Harrishayy/SysEng/SystemsEngineering_Team05_Presentation.pdf

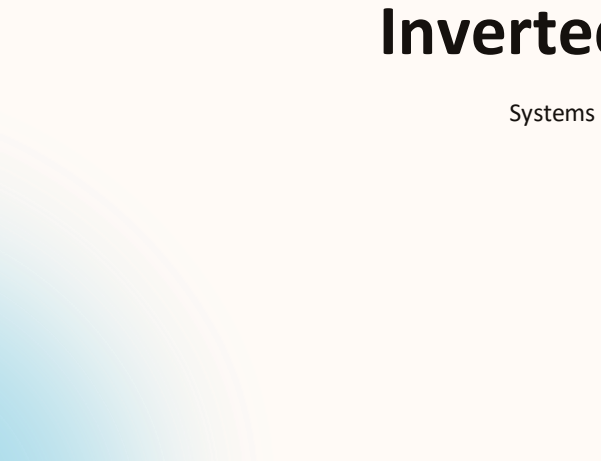
[picture p40: figure]

# Inverted Pendulum

### Systems Engineering – Team 05

# Equations of Motion

Non-linear Dynamics (Lagrangian Approach):

We derived the system's "True Physics" using the Euler-Lagrange method to capture real-world non-linearities like centripetal forces

Translation:

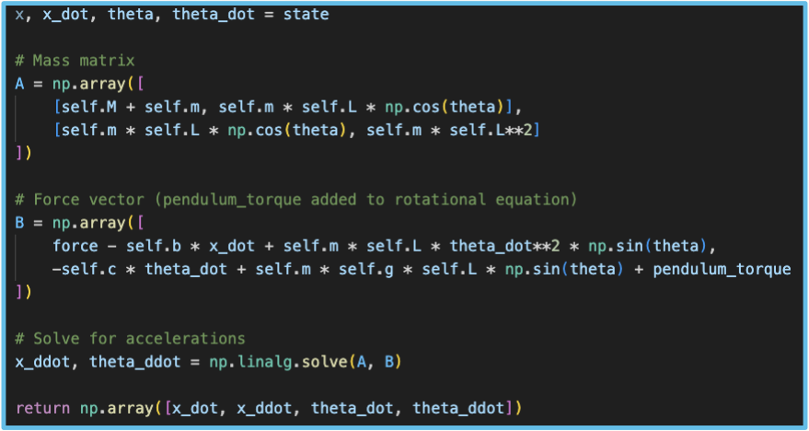
[picture p41: figure]

Rotation:

Code Implementation:

In our Python implementation, we utilize a Mass Matrix (A) and a Force Vector (B̈) to solve for accelerations (ẍ, θ̈) at every time step.

State Representation: The system state is tracked as a 4D vector:

# Controller Design - PID

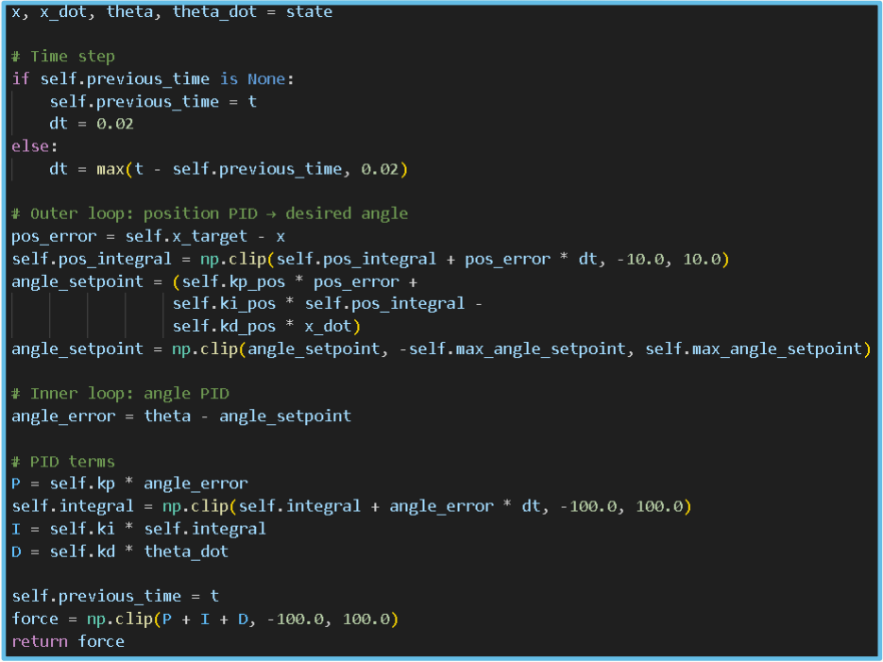
[picture p42: figure]
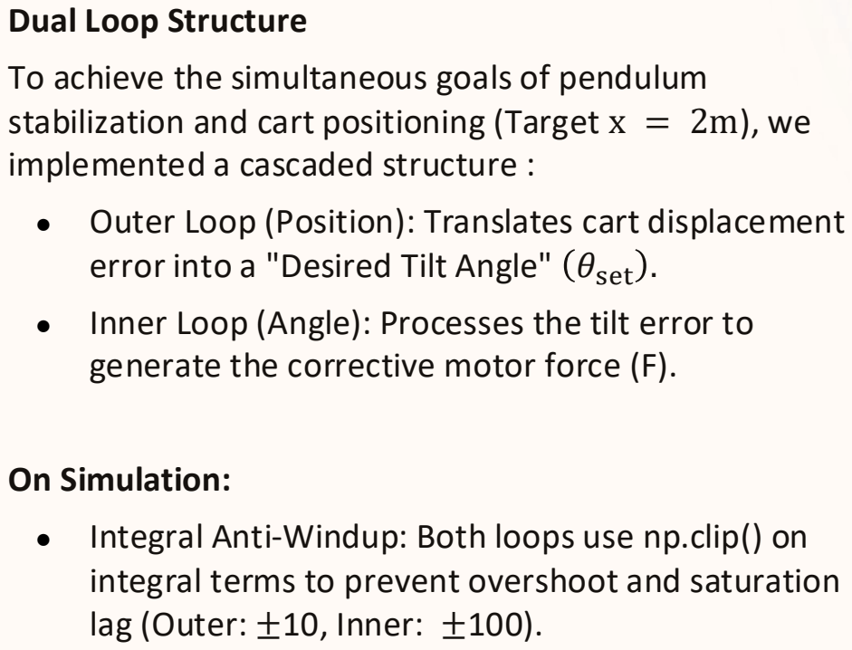
[picture p43: figure]
Dual Loop Structure; implemented a cascaded structure :; On Simulation:; lag (Outer: ±10, Inner: ±100).

To achieve the simultaneous goals of pendulum stabilization and cart positioning (Target x = 2m), we

- Outer Loop (Position): Translates cart displacement error into a "Desired Tilt Angle" θset .
- Inner Loop (Angle): Processes the tilt error to generate the corrective motor force (F).
- Integral Anti-Windup: Both loops use np.clip() on integral terms to prevent overshoot and saturation

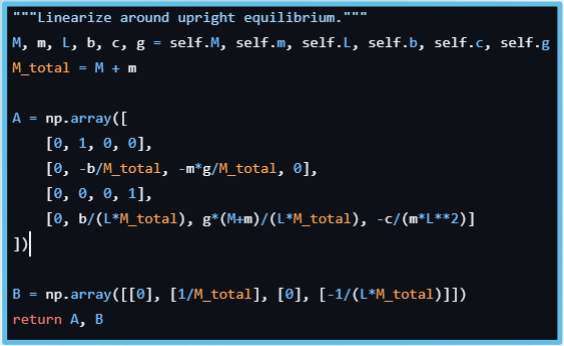
[picture p44: figure]

# Controller Design - LQR

Optimal State-Feedback Control Strategy

Unlike our PID controller, which uses a dual loop structure, the LQR uses a single unified controller.

Target state: x = [2 0 0 0]T
First the dynamics are linearised (state x = [x ẋ θ θ])
into the form ẋ = A x + B u.

Then, the quadratic cost function is minimised.

Control Law

The optimal feedback gain K is then computed by solving the CARE equation. The control force is then calculated as:

u=−K(x−xsetpoint )

where K = [kx

, kẋ

, kθ

, kθ

]

Therefore, all 4 states (position, velocity, angle, angular velocity) contribute to the control force simultaneously.

# Controller Design – Pole Placement

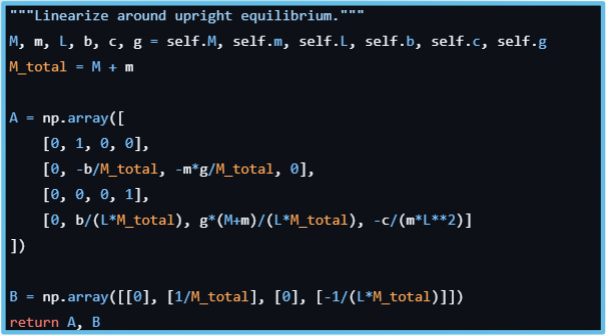
[picture p45: figure]

### Optimised State-Feedback Control Strategy

Rather than optimising a cost function like LQR, pole placement directly assigns the closed loop dynamics of the system. The rest of the initial setup for this design is the same as LQR: same target x and linearising the state.

### Control Law

Rather than solving the CARE equation, the gain matrix K is calculated such that eig(A-BK) = desired poles

It then uses the same logic as LQR to compute the control force, therefore all states contribute to the force simultaneously.

# Sensor Noise and Hardware Realism

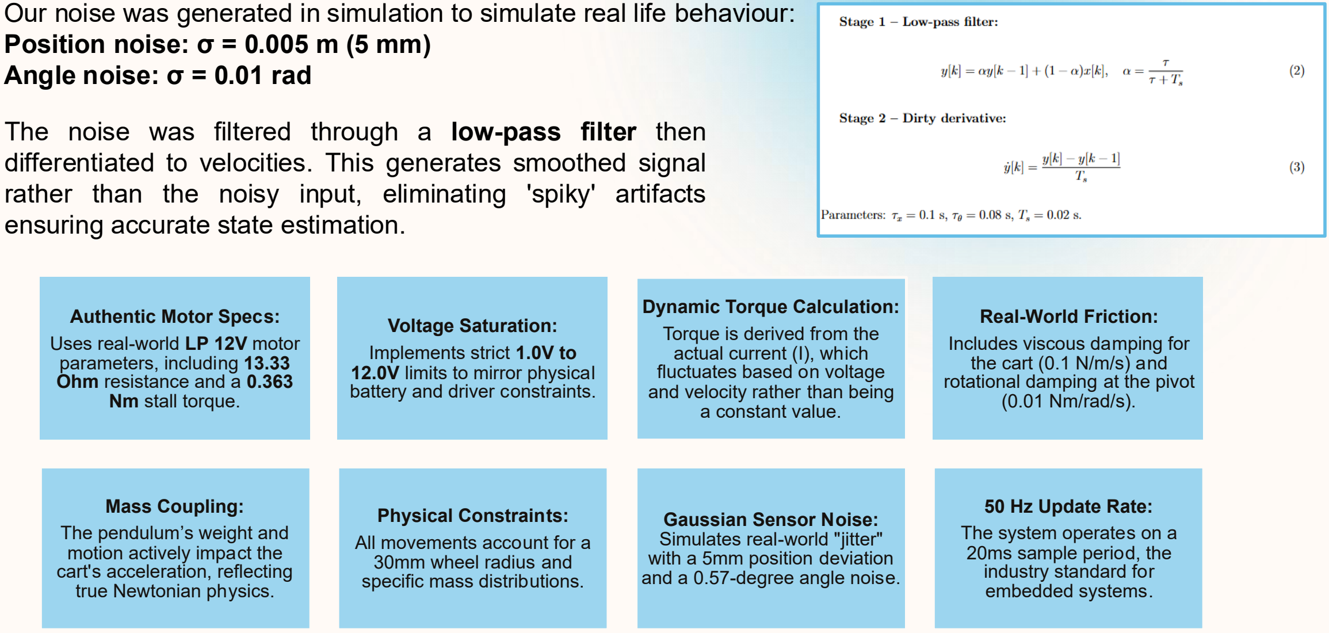
[picture p46: figure]
Position noise: σ = 0.005 m (5 mm) Angle noise: σ = 0.01 rad; ensuring accurate state estimation.; Authentic Motor Specs:; Uses real-world LP 12V motor parameters, including 13.33 Ohm resistance and a 0.363 Nm stall torque.; Voltage Saturation:; Implements strict 1.0V to 12.0V limits to mirror physical battery and driver constraints.; Dynamic Torque Calculation:; Torque is derived from the actual current (I), which fluctuates based on voltage and velocity rather than being a constant value.; Real-World Friction:; Includes viscous damping for the cart (0.1 N/m/s) and rotational damping at the pivot (0.01 Nm/rad/s).; Mass Coupling:; The pendulum’s weight and motion actively impact the cart's acceleration, reflecting true Newtonian physics.; Physical Constraints:; All movements account for a 30mm wheel radius and specific mass distributions.; Gaussian Sensor Noise: Simulates real-world "jitter" with a 5mm position deviation and a 0.57-degree angle noise.; 50 Hz Update Rate:; The system operates on a 20ms sample period, the industry standard for embedded systems.

Our noise was generated in simulation to simulate real life behaviour:

The noise was filtered through a low-pass filter then differentiated to velocities. This generates smoothed signal rather than the noisy input, eliminating 'spiky' artifacts

# Batch Comparison

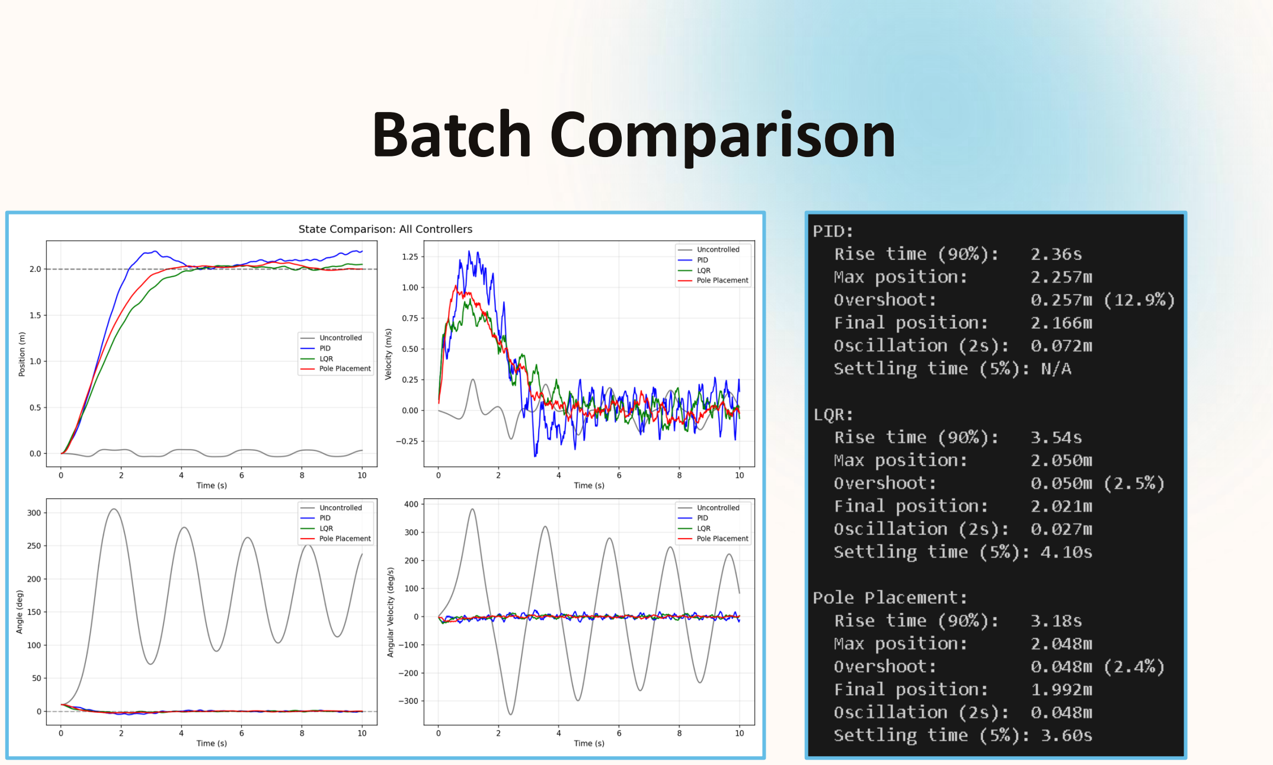
[picture p47: page 7]

# Performance Testing

Max Initial Angle Test
- Uses binary search between 5° and 60° to find the largest starting tilt the controller can recover from
- Runs 10-second simulation with noise and motor constraints
- Pass criteria: Pendulum stays within ±90° throughout AND ends within ±30°

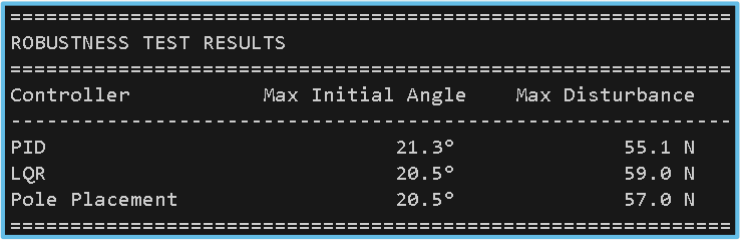
[picture p48: figure]

Max Disturbance Test
- Starts with small 5° tilt, applies an impulse force at t=2s
- Binary searches between 0-100N to find maximum survivable push
- Simulates real-world bumps/collisions the system might experience
