Harrishayy/SysEng/hardware_plots/fig_dist_pos.png

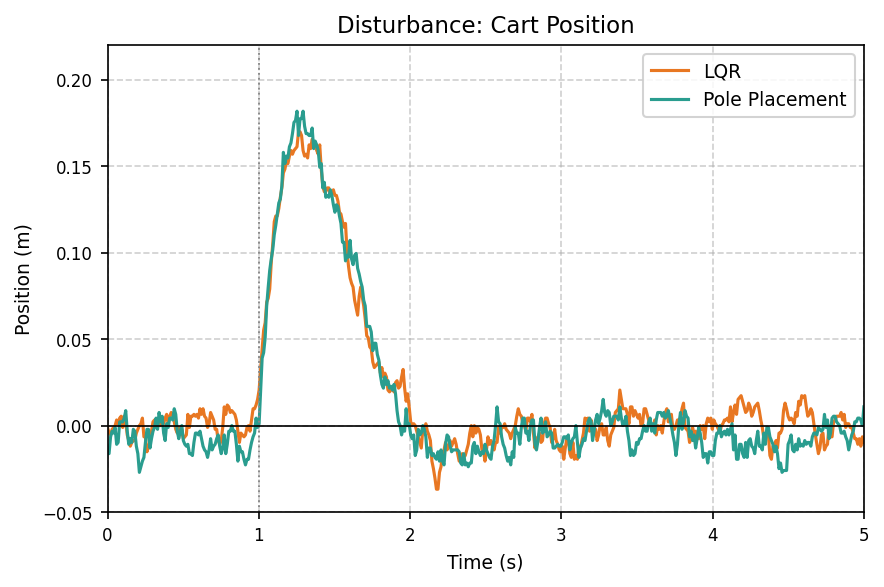
hardware_plots/fig_dist_pos.png
