Harrishayy/SysEng/hardware_plots/fig_sprint_pos.png

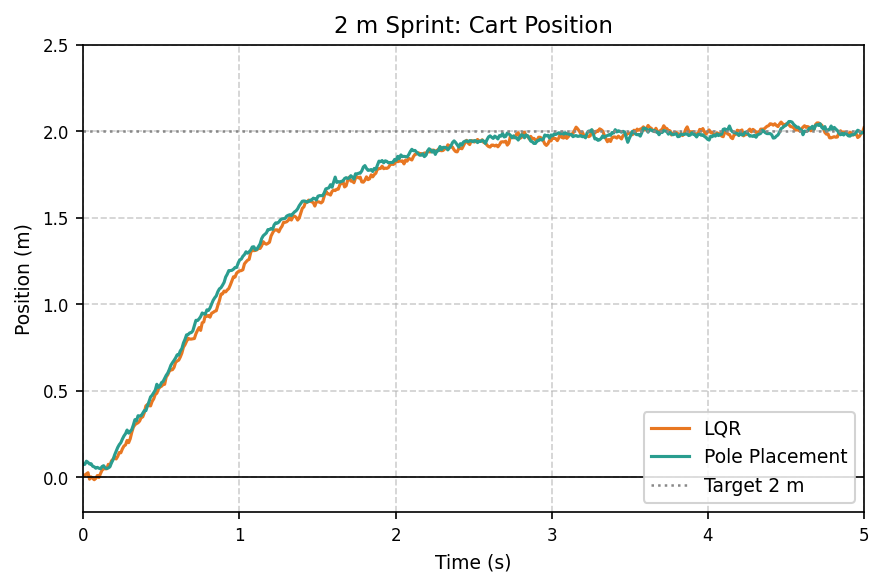
hardware_plots/fig_sprint_pos.png
