Harrishayy/SysEng/plots/comparison_angle.png

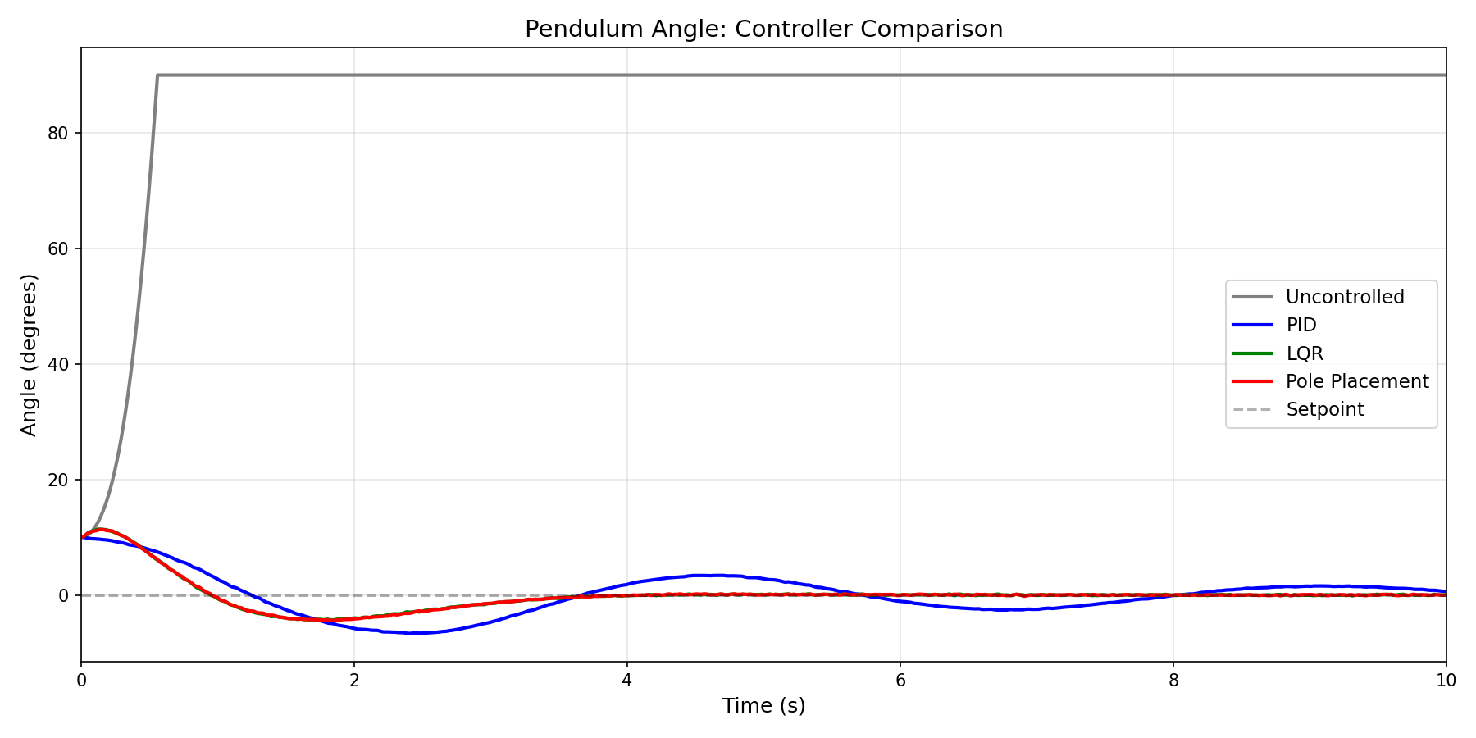
plots/comparison_angle.png
