Harrishayy/SysEng/plots/comparison_control.png

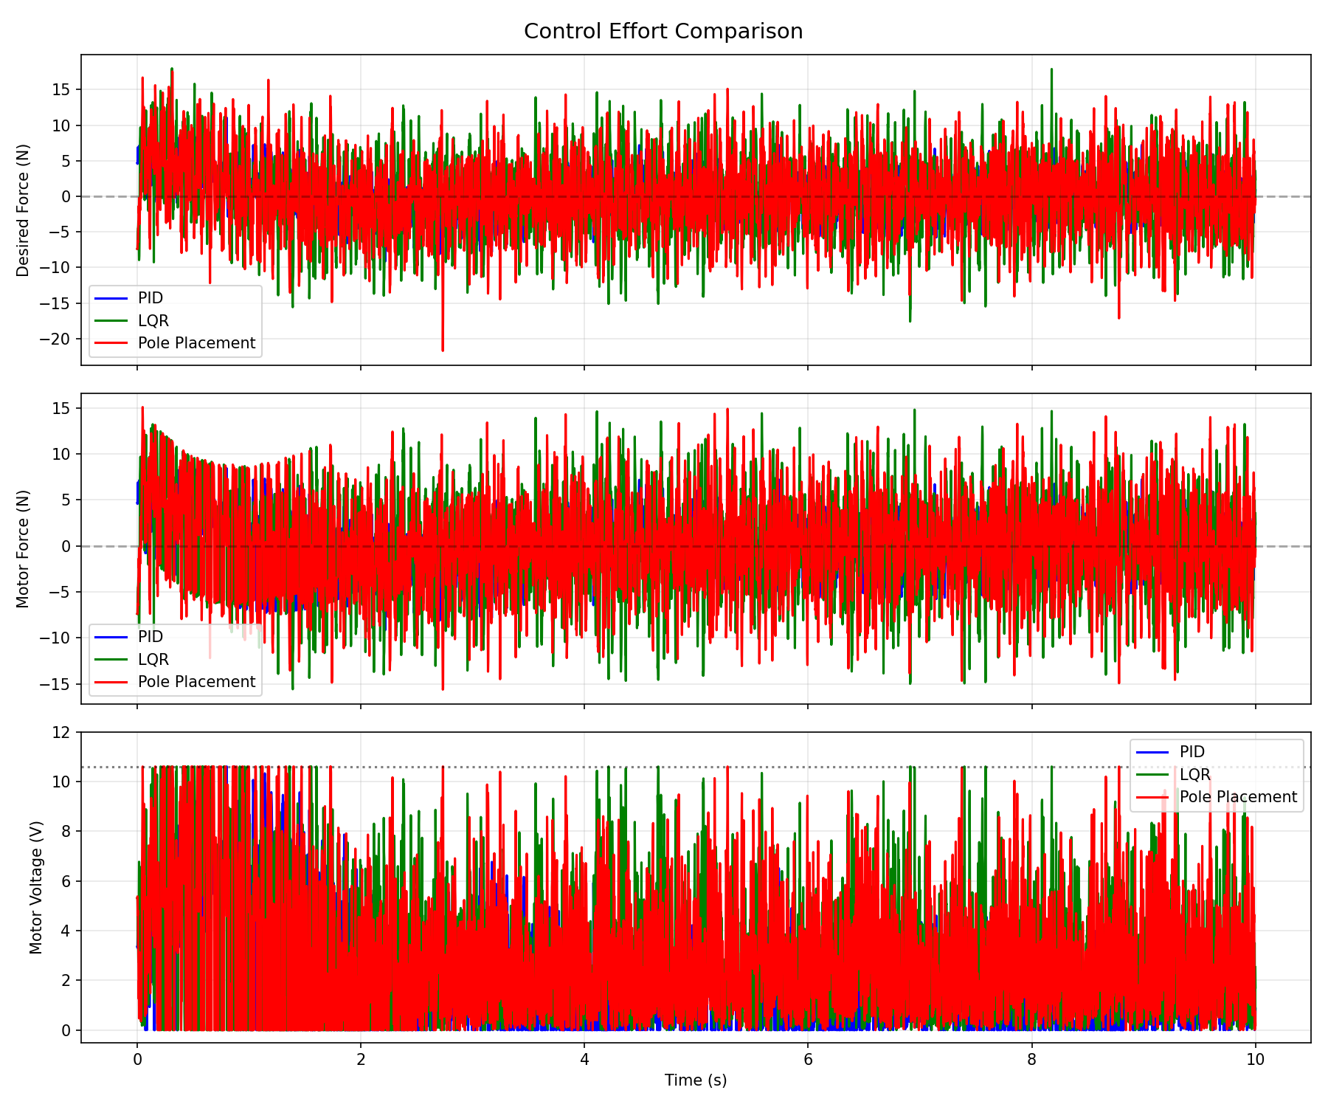
plots/comparison_control.png
