Harrishayy/SysEng/plots/comparison_metrics.png

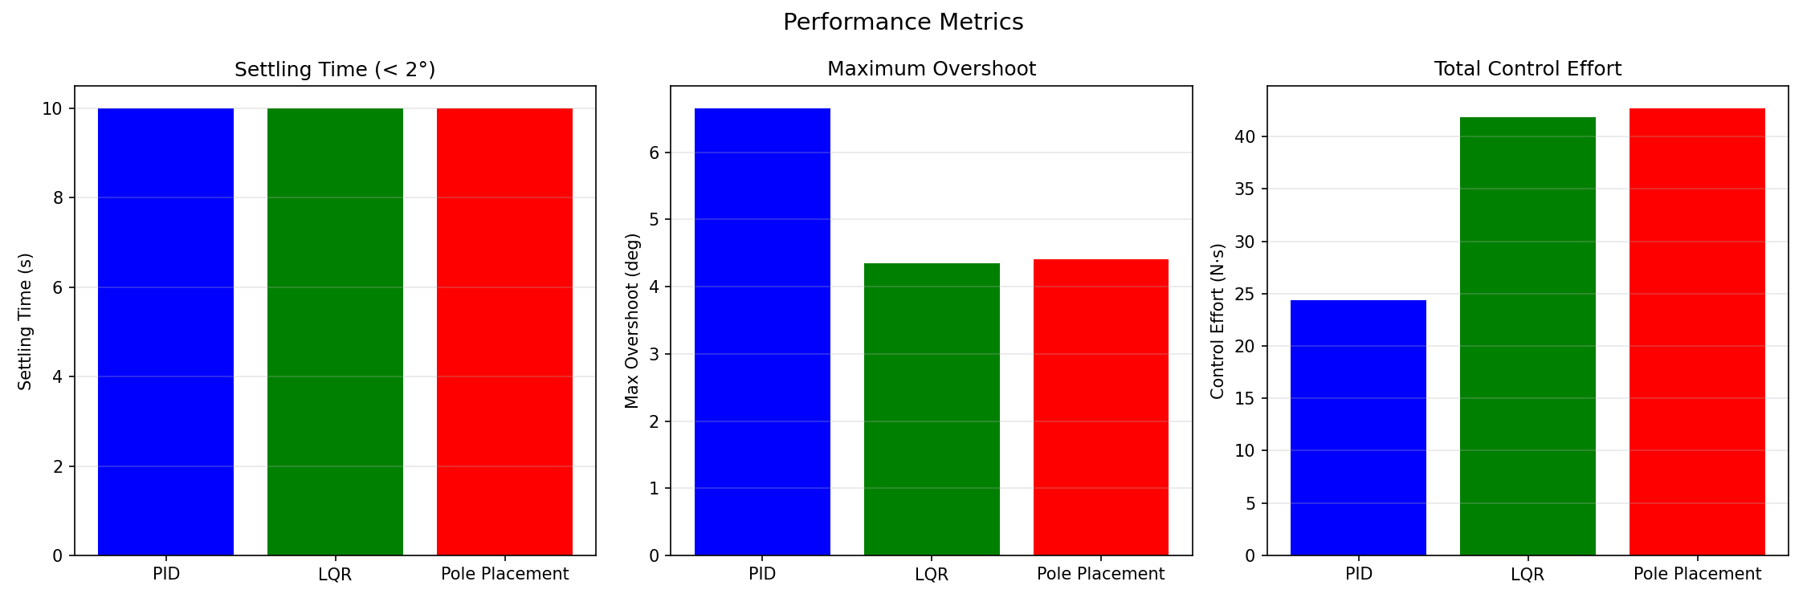
plots/comparison_metrics.png
