Harrishayy/SysEng/plots/comparison_phase.png

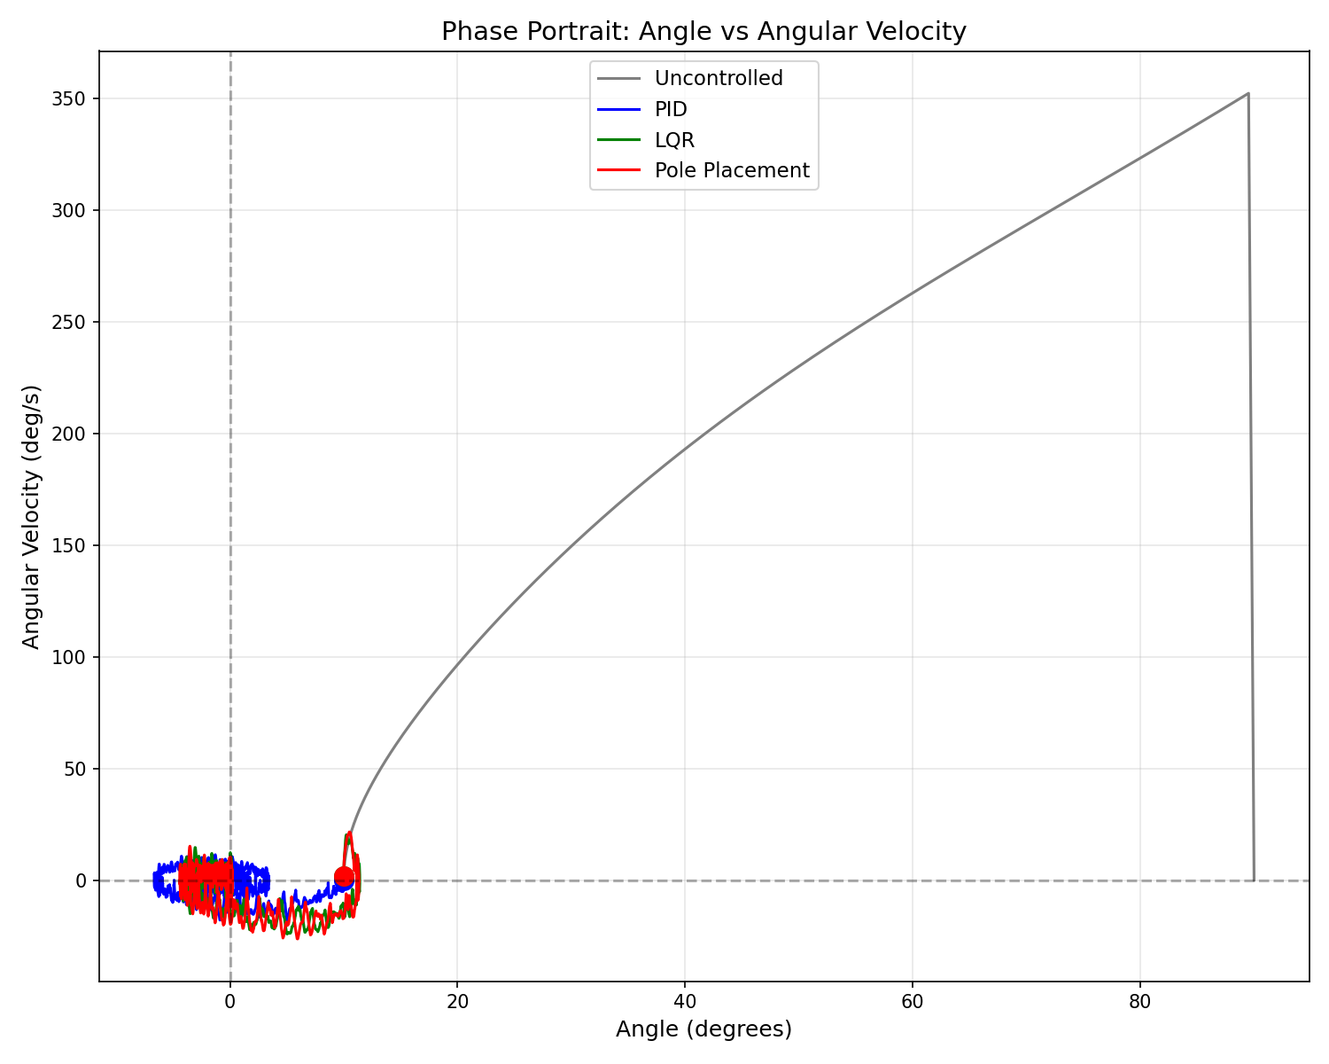
plots/comparison_phase.png
