Harrishayy/SysEng/plots/comparison_position.png

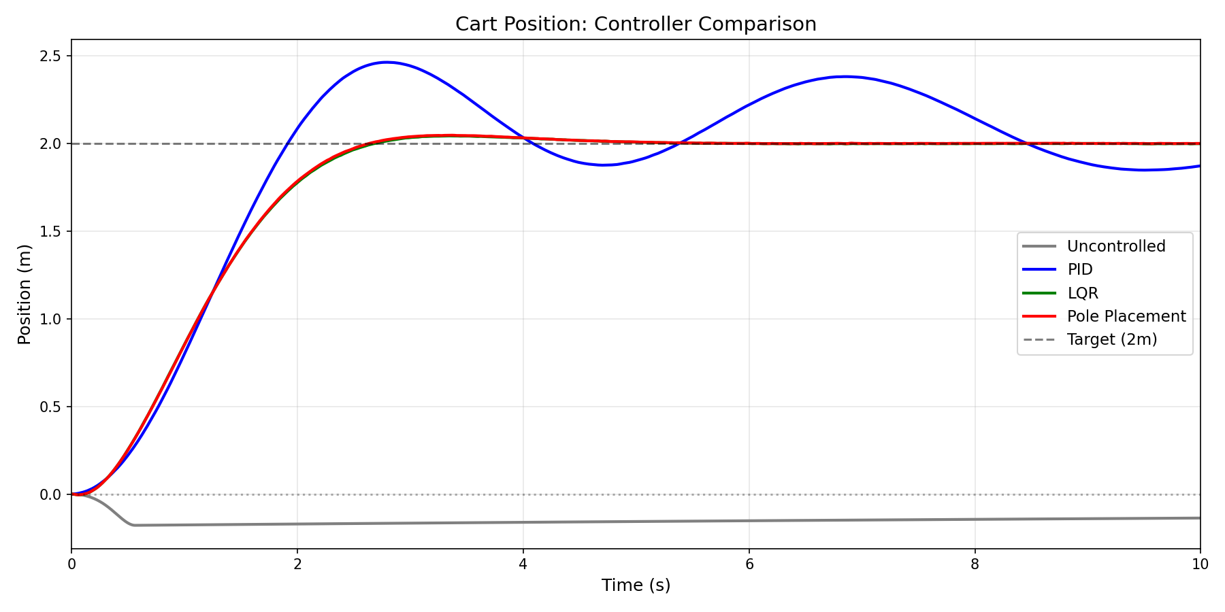
plots/comparison_position.png
