Harrishayy/SysEng/Sensors/Tests/SwingTestResult.txt

AS22 Encoder Test Initialized
Assumed CPR: 1000.00
Count: 39	 Angle: 14.04 deg
Count: 39	 Angle: 14.04 deg
Count: 40	 Angle: 14.40 deg
Count: 40	 Angle: 14.40 deg
Count: 40	 Angle: 14.40 deg
Count: 40	 Angle: 14.40 deg
Count: 40	 Angle: 14.40 deg
Count: 40	 Angle: 14.40 deg
Count: 40	 Angle: 14.40 deg
Count: 39	 Angle: 14.04 deg
Count: 39	 Angle: 14.04 deg
Count: 39	 Angle: 14.04 deg
Count: 39	 Angle: 14.04 deg
Count: 38	 Angle: 13.68 deg
Count: 38	 Angle: 13.68 deg
Count: 37	 Angle: 13.32 deg
Count: 37	 Angle: 13.32 deg
Count: 36	 Angle: 12.96 deg
Count: 35	 Angle: 12.60 deg
Count: 34	 Angle: 12.24 deg
Count: 34	 Angle: 12.24 deg
Count: 33	 Angle: 11.88 deg
Count: 32	 Angle: 11.52 deg
Count: 31	 Angle: 11.16 deg
Count: 30	 Angle: 10.80 deg
Count: 28	 Angle: 10.08 deg
Count: 27	 Angle: 9.72 deg
Count: 26	 Angle: 9.36 deg
Count: 24	 Angle: 8.64 deg
Count: 23	 Angle: 8.28 deg
Count: 22	 Angle: 7.92 deg
Count: 20	 Angle: 7.20 deg
Count: 19	 Angle: 6.84 deg
Count: 17	 Angle: 6.12 deg
Count: 15	 Angle: 5.40 deg
Count: 14	 Angle: 5.04 deg
Count: 12	 Angle: 4.32 deg
Count: 10	 Angle: 3.60 deg
Count: 9	 Angle: 3.24 deg
Count: 7	 Angle: 2.52 deg
Count: 6	 Angle: 2.16 deg
Count: 4	 Angle: 1.44 deg
Count: 2	 Angle: 0.72 deg
Count: 1	 Angle: 0.36 deg
Count: -1	 Angle: 359.64 deg
Count: -3	 Angle: 358.92 deg
Count: -4	 Angle: 358.56 deg
Count: -6	 Angle: 357.84 deg
Count: -8	 Angle: 357.12 deg
Count: -10	 Angle: 356.40 deg
Count: -11	 Angle: 356.04 deg
Count: -13	 Angle: 355.32 deg
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
Count: 16	 Angle: 5.76 deg
Count: 17	 Angle: 6.12 deg
Count: 19	 Angle: 6.84 deg
Count: 20	 Angle: 7.20 deg
Count: 21	 Angle: 7.56 deg
Count: 21	 Angle: 7.56 deg
Count: 22	 Angle: 7.92 deg
Count: 23	 Angle: 8.28 deg
Count: 24	 Angle: 8.64 deg
Count: 24	 Angle: 8.64 deg
Count: 25	 Angle: 9.00 deg
