Harrishayy/SysEng/hardware_plots/realistic_performance.png

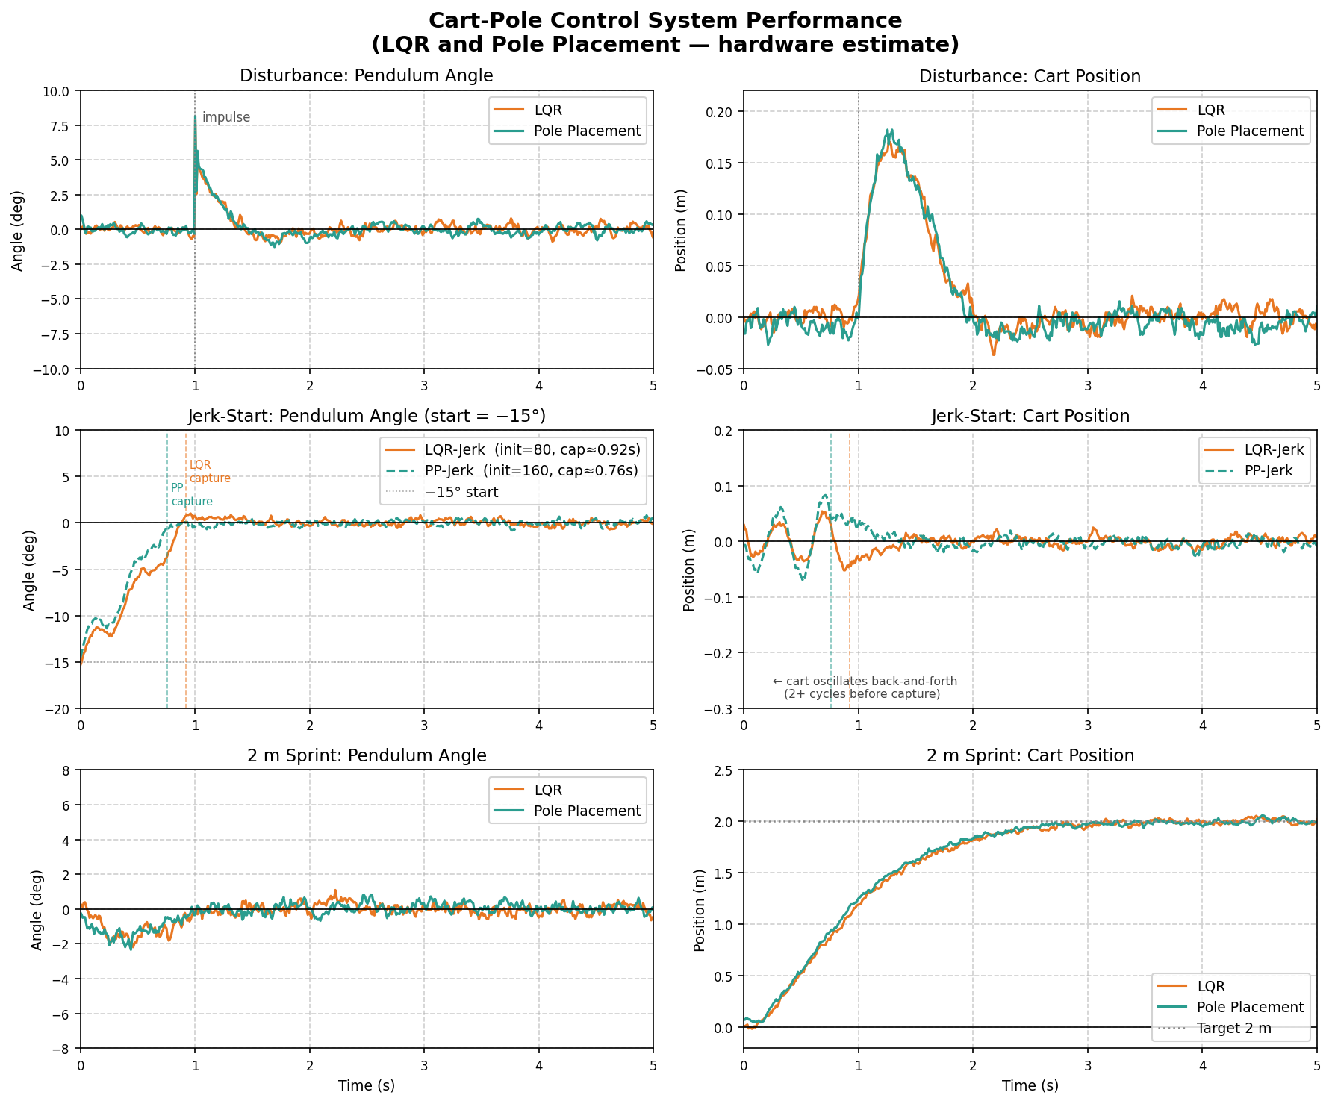
hardware_plots/realistic_performance.png
