Harrishayy/SysEng/Sensors/Tests/SwingTestAnalysisFigure.png

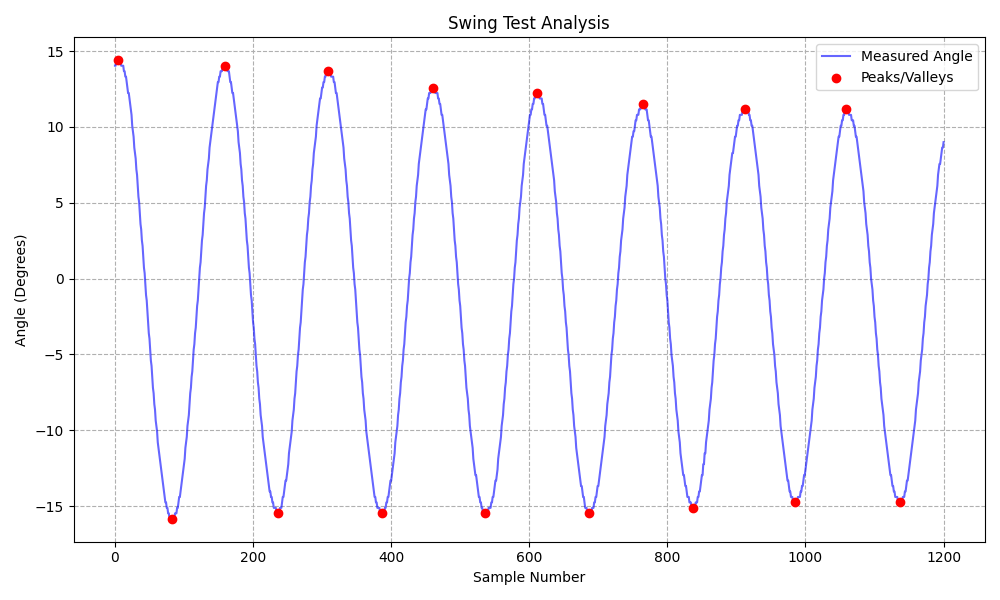
Sensors/Tests/SwingTestAnalysisFigure.png
