Harrishayy/SysEng/Sensors/Tests/GetRawAngle/GetRawAngle.ino

#include <FreeSixIMU.h>
#include <FIMU_ADXL345.h>
#include <FIMU_ITG3200.h>

#include <Wire.h>

float angles[3]; // yaw pitch roll

// Set the FreeSixIMU object
FreeSixIMU sixDOF = FreeSixIMU();

void setup() {
  Serial.begin(9600);
  Wire.begin();

  delay(5);
  sixDOF.init(); //begin the IMU
  delay(5);
}

void loop() {

  sixDOF.getEuler(angles);

  Serial.print(angles[0]);
  Serial.print(" | ");
  Serial.print(angles[1]);
  Serial.print(" | ");
  Serial.println(angles[2]);

  delay(100);
}
