Harrishayy/SysEng/(commit log)

2026-01-18 implemented simple PID control
2026-01-21 Tuned PID Controller
2026-01-21 Injected noise and added filtering
    [GetAngularVelAndAccel.ino, GetRawAngle.ino, HardwareDetectionTest.ino, main_smc.py, state_filter.py]
2026-01-21 Replaced SMC with pole placement algorithm
    [controller.py]
2026-01-22 Updates: - Removed redundant main files - More aggressive noise filtering - Improved interactive visualisation - Added motor dynamics
    [generate_plots.py, main_interactive.py, motor.py, state_filter.py]
2026-01-27 Added option for pendulum impulse disturbance and test code for motors
2026-02-01 Updated motor paramters and retuned controllers
    [tuned_parameters.txt]
2026-02-01 Removed tuning script
    [tuned_parameters.txt]
2026-02-01 Fixed dt in PID
    [controller.py]
2026-02-01 Updated plots and tuned PID
2026-02-01 Reverted PID values to better tuned state
    [controller.py, main_interactive.py, metrics.py]
2026-03-04 Update LQR code, added moving average filter
2026-03-05 Latest working LQR - currently tuning distance
2026-03-11 Increase position derivative gain for improved stability in LQR control
    [LQRJerkStartStabilisation.ino]
2026-03-12 Add LQR inverted pendulum controller and gain calculation script
    [LQRJerkStartStabilisation.ino, LQRPendulum.ino, calculate_gains.py]
2026-03-16 Refactor LQR Stabilisation Code: Remove original implementation and replace with improved version featuring cascaded control, enhanced stability, and better filtering. Key changes include non-zero an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
2026-03-16 Add jerk-start PID/PP sketches and unify hardware firmware
    - Rewrite PIDStabilisation.ino: cascaded PID (gains from src/controller.py),
    full quadrature encoders, force-based output (54.33 cmd/N), 500 Hz loop,
    MA(5) + exponential LP filter, safety cutout at |θ|>0.52 rad — matching
    the structure of LQRPendulum.ino throughout
    - Add PIDJerkStartStabilisation: jerk-start state machine (IDLE → JERK_ACCEL
    → JERK_BRAKE → STABILIZE) handing off to cascaded PID on capture
    - Add PolePlacementJerkStartStabilisation: same jerk-start sequence handing
    off to pole placement with reference governor on capture
    - Update README: fix PolePlacementStabilisation → PolePlacementPendulum,
    add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
    [PolePlacementJerkStartStabilisation.ino]
2026-03-18 Working battery
2026-03-23 Update .gitignore, enhance README, and refine metrics calculations
    - Added entries for virtual environments, generated outputs, and IDE files to .gitignore.
    - Updated README with improved descriptions and specifications for simulation and hardware.
    - Adjusted metrics.py for consistent time steps and refined noise parameters in analysis.
    - Corrected comments in motor.py for clarity on maximum force calculation.
    [metrics.py, motor.py]
2026-03-27 Attached report
